pikim/blackmagic-hardware/contrib/pikim/blackmagic_richardeoin.pdf

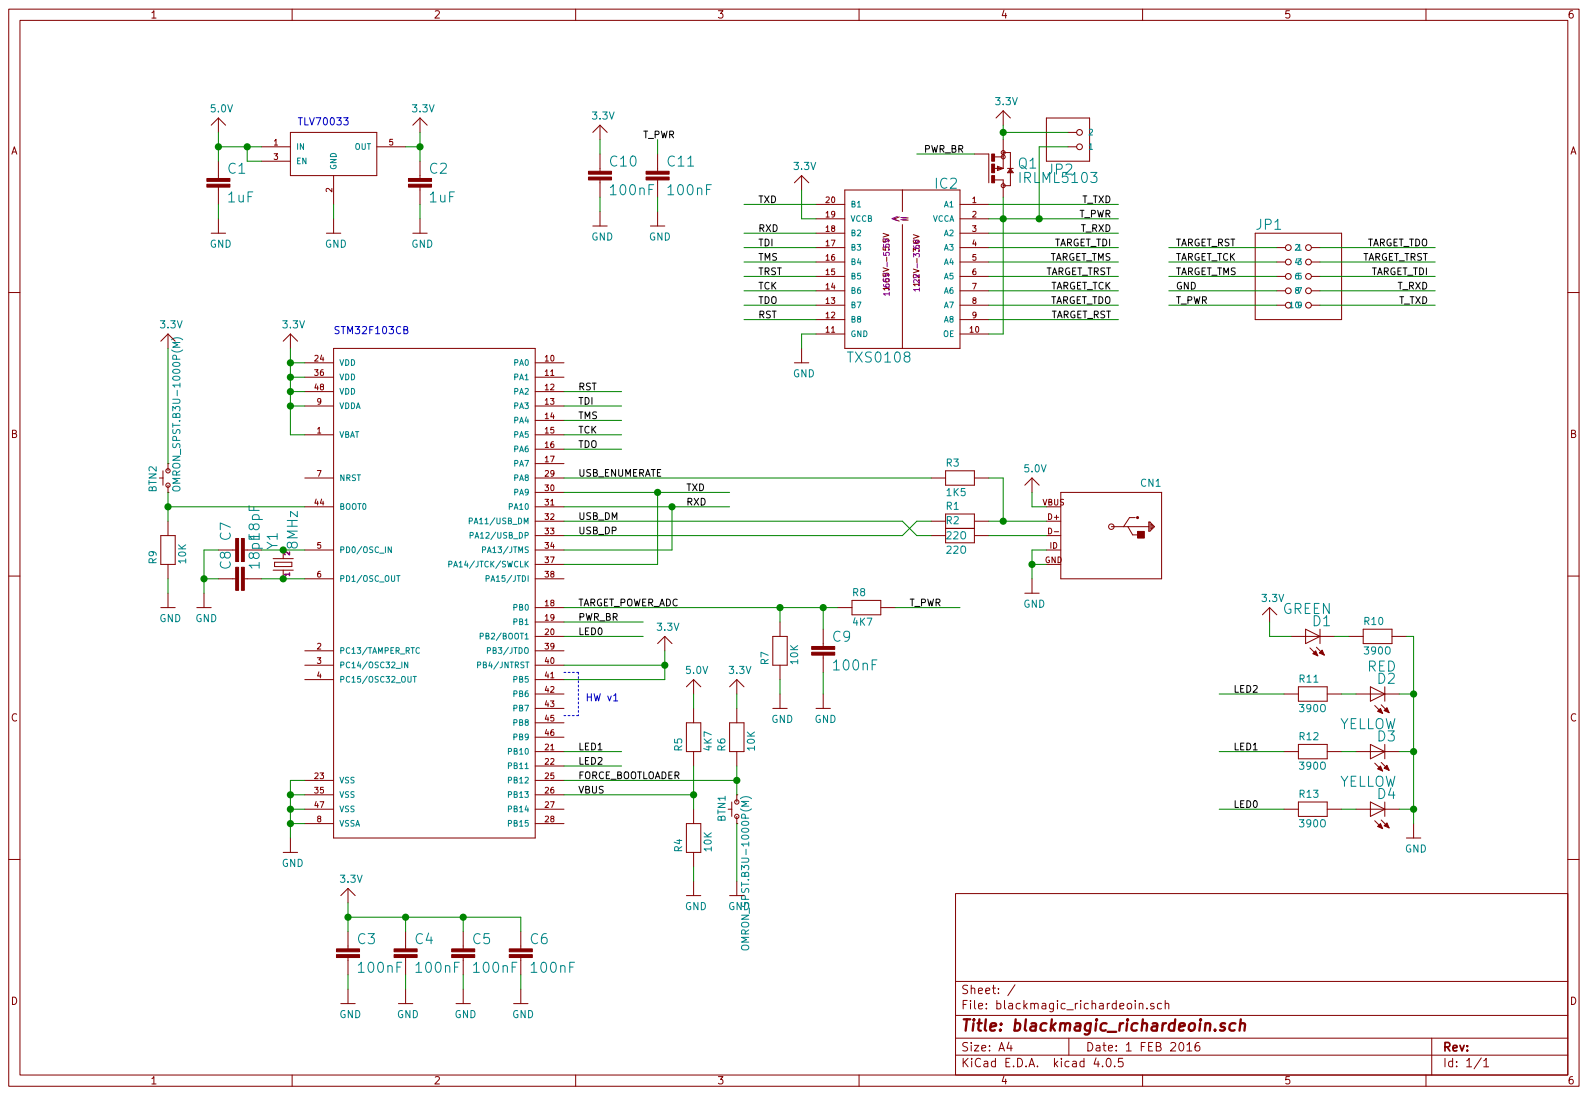
[picture p3: page 1]
