pikim/blackmagic-hardware/contrib/pikim/blackmagic_richardeoin.kicad_pcb

## KiCad design contrib/pikim/blackmagic_richardeoin.kicad_pcb (2017-02-18)

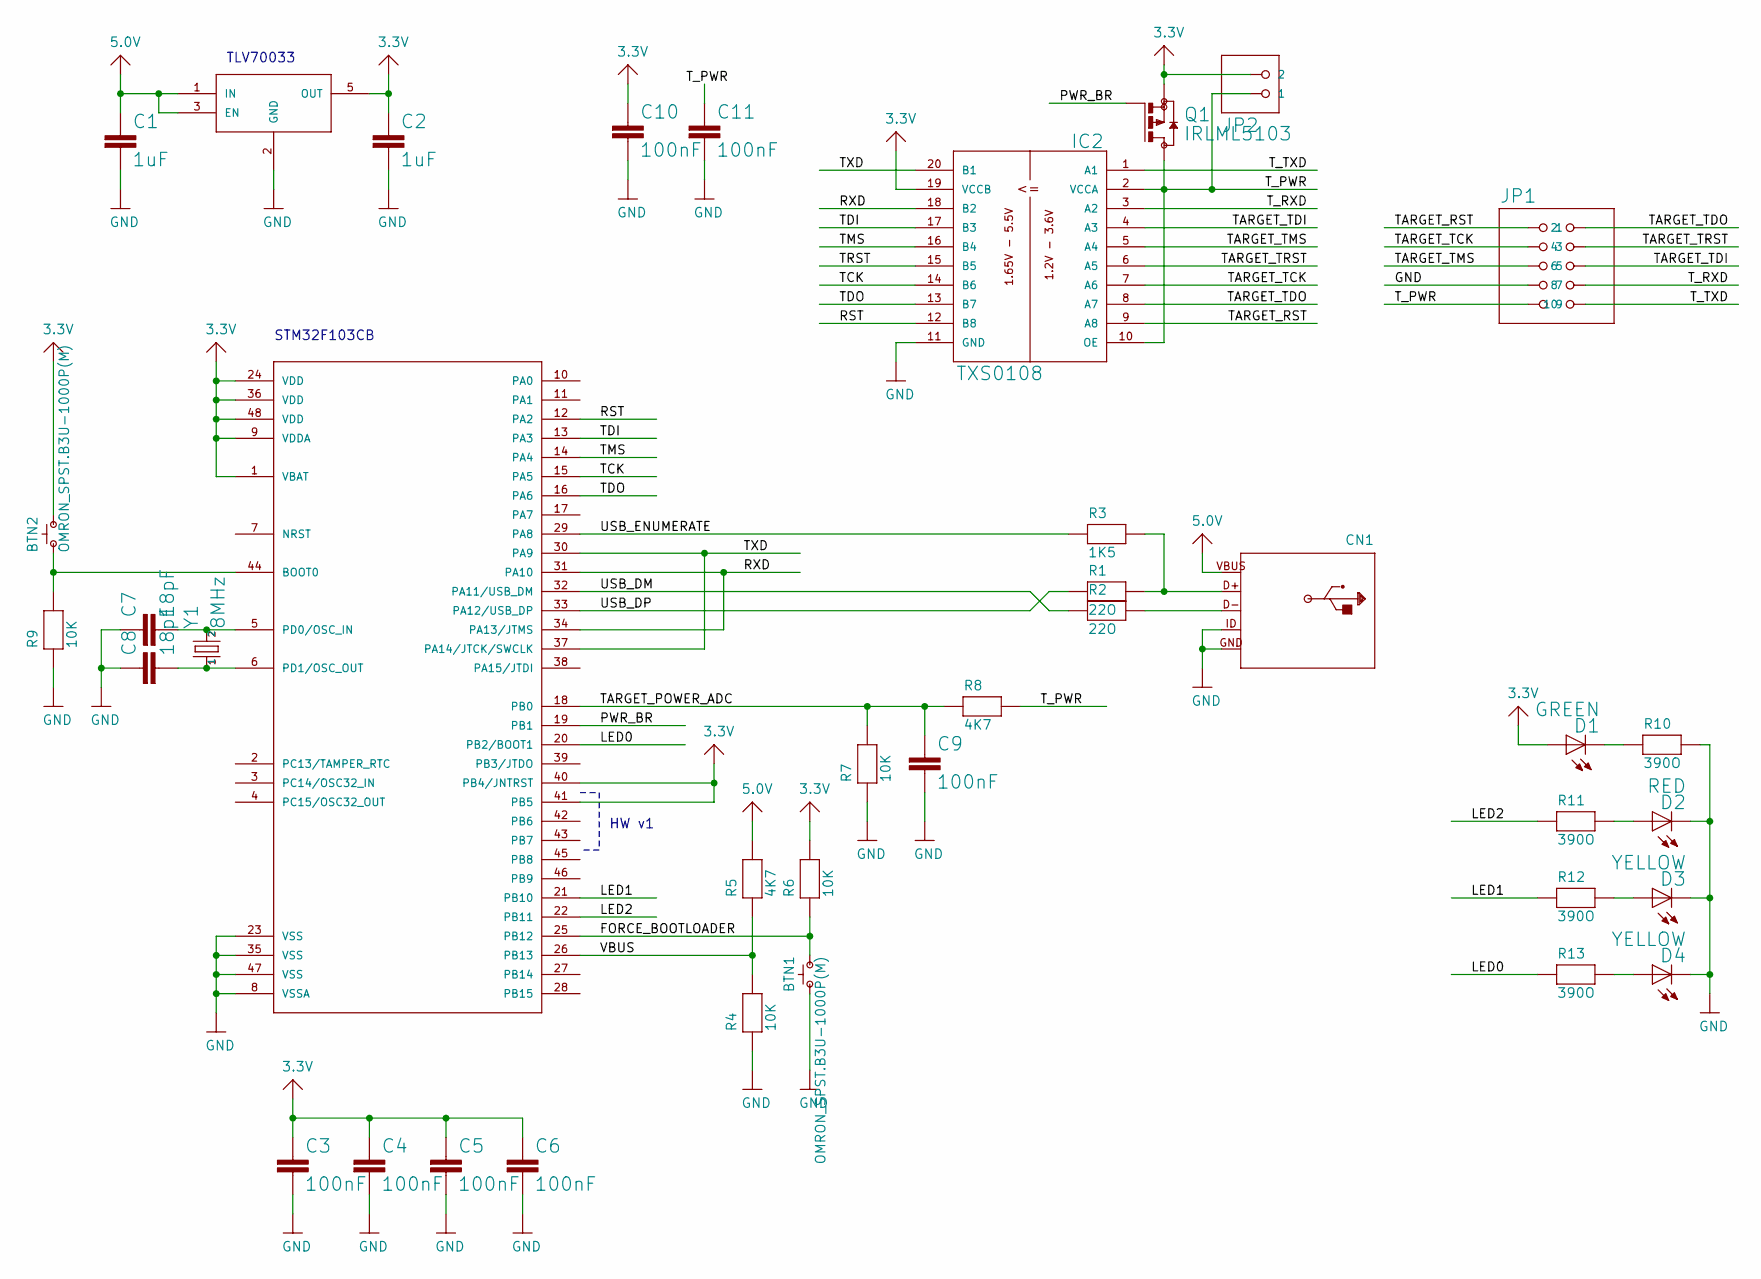
[picture p4: schematic blackmagic_richardeoin.sch]

Parts:
BTN1, BTN2: OMRON_SPST.B3U-1000P(M); BLACKMAGIC_RICHARDEOIN_OMRON_B3U-1000P(M)
C1, C2: 1uF; RESISTOR_C0603K
C3, C4, C5, C6, C9, C10, C11: 100nF; RESISTOR_C0603K
C7, C8: 18pF; RESISTOR_C0603K
CN1: MICROBUILDER_V3_USB-MINIB
D1: GREEN; LED_CHIPLED_0603
D2: RED; LED_CHIPLED_0603
D3, D4: YELLOW; LED_CHIPLED_0603
IC1: STM32F_48PIN; STM32F_TQFP48
IC2: TXS0108; DAN-TRANSLATE_TSSOP20
IC3: TLV70033DCK; BLACKMAGIC_RICHARDEOIN_TLV700_SC70-5L
JP1: PINHEAD_2X05
JP2: PINHEAD-2_1X02SMD_90-BIGPADS
Q1: IRLML5103; TRANSISTOR-SMALL-SIGNAL_SOT23
R1, R2: 22O; MICROBUILDER_0603-MINI
R3: 1K5; MICROBUILDER_0603-MINI
R4, R6, R7, R9: 10K; MICROBUILDER_0603-MINI
R5, R8: 4K7; MICROBUILDER_0603-MINI
R10, R11, R12, R13: 390O; MICROBUILDER_0603-MINI
Y1: 8MHz; SPARKFUN_CRYSTAL-SMD-5X3

Connections:
3.3V: BTN2.2, C2.1, C3.1, C4.1, C5.1, C6.1, C10.1, D1.A, IC1.1 (VBAT), IC1.9 (VDDA), IC1.24 (VDD), IC1.36 (VDD), IC1.40 (PB4/JNTRST), IC1.41 (PB5), IC1.48 (VDD), IC2.19 (VCCB), IC3.5 (OUT), JP2.2, Q1.2 (S), R6.2
5.0V: C1.1, CN1.VBUS, IC3.1 (IN), IC3.3 (EN), R5.2
BOOT0: BTN2.1, IC1.44 (BOOT0), R9.2
D+: CN1.D+, R1.2, R3.2
D-: CN1.D-, R2.2
FORCE_BOOTLOADER: BTN1.1, IC1.25 (PB12), R6.1
GND: BTN1.2, C1.2, C2.2, C3.2, C4.2, C5.2, C6.2, C7.1, C8.1, C9.2, C10.2, C11.2, CN1.GND, CN1.GND1, CN1.GND2, CN1.GND3, CN1.GND4, CN1.ID, D2.C, D3.C, D4.C, IC1.8 (VSSA), IC1.23 (VSS), IC1.35 (VSS), IC1.47 (VSS), IC2.11 (GND), IC3.2 (GND), JP1.7, R4.1, R7.1, R9.1, R10.2
LED0: IC1.20 (PB2/BOOT1), R13.1
LED1: IC1.21 (PB10), R12.1
LED2: IC1.22 (PB11), R11.1
LPC_XTAL2: C8.2, IC1.6 (PD1/OSC_OUT), Y1.1
unnamed: D2.A, R11.2
unnamed: D1.C, R10.1
unnamed: D3.A, R12.2
unnamed: D4.A, R13.2
OSC_IN: C7.2, IC1.5 (PD0/OSC_IN), Y1.3 (2)
PWR_BR: IC1.19 (PB1), Q1.1 (G)
RST: IC1.12 (PA2), IC2.12 (B8)
RXD: IC1.31 (PA10), IC1.34 (PA13/JTMS), IC2.18 (B2)
TARGET_POWER_ADC: C9.1, IC1.18 (PB0), R7.2, R8.1
TARGET_RST: IC2.9 (A8), JP1.1
TARGET_TCK: IC2.7 (A6), JP1.3
TARGET_TDI: IC2.4 (A3), JP1.6
TARGET_TDO: IC2.8 (A7), JP1.2
TARGET_TMS: IC2.5 (A4), JP1.5
TARGET_TRST: IC2.6 (A5), JP1.4
TCK: IC1.15 (PA5), IC2.14 (B6)
TDI: IC1.13 (PA3), IC2.17 (B3)
TDO: IC1.16 (PA6), IC2.13 (B7)
TMS: IC1.14 (PA4), IC2.16 (B4)
TRST: IC2.15 (B5)
TXD: IC1.30 (PA9), IC1.37 (PA14/JTCK/SWCLK), IC2.20 (B1)
T_PWR: C11.1, IC2.2 (VCCA), IC2.10 (OE), JP1.9, JP2.1, Q1.3 (D), R8.2
T_RXD: IC2.3 (A2), JP1.8
T_TXD: IC2.1 (A1), JP1.10
USB_DM: IC1.32 (PA11/USB_DM), R2.1
USB_DP: IC1.33 (PA12/USB_DP), R1.1
USB_ENUMERATE: IC1.29 (PA8), R3.1
VBUS: IC1.26 (PB13), R4.2, R5.1

Notes on the sheet:
STM32F103CB
HW v1
TLV70033

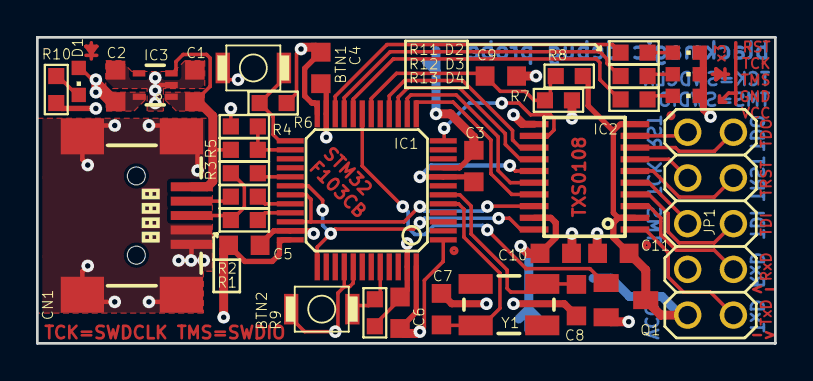
[picture p5: board blackmagic_richardeoin.kicad_pcb from above]

Board: 2 copper layers, 41.0 x 17.0 mm, 39 parts (0 on the bottom side), 38 nets.

Other parts of the board:
U$32: LP_NUMBER_SILK_TOP
